smartboxchannel/WIRELESS-TEMPERATURE-HUMIDITY-SENSOR-V1-nRF52840-E73/IMAGES/BOTTOM.png

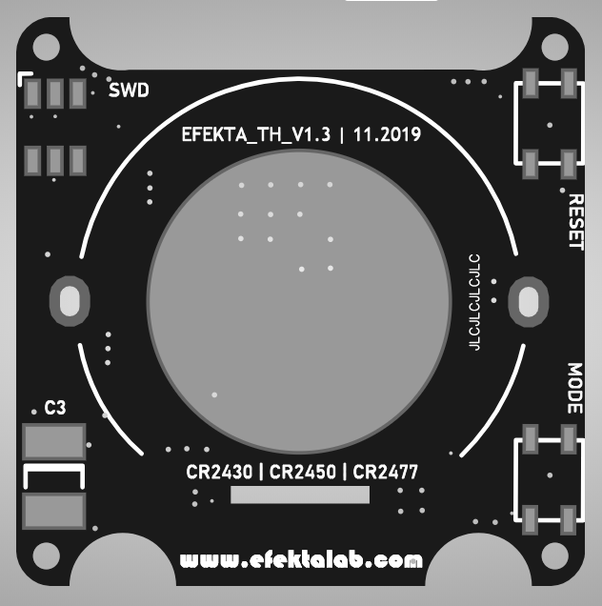
IMAGES/BOTTOM.png
