smartboxchannel/WIRELESS-TEMPERATURE-HUMIDITY-SENSOR-V1-nRF52840-E73/IMAGES/TOP.png

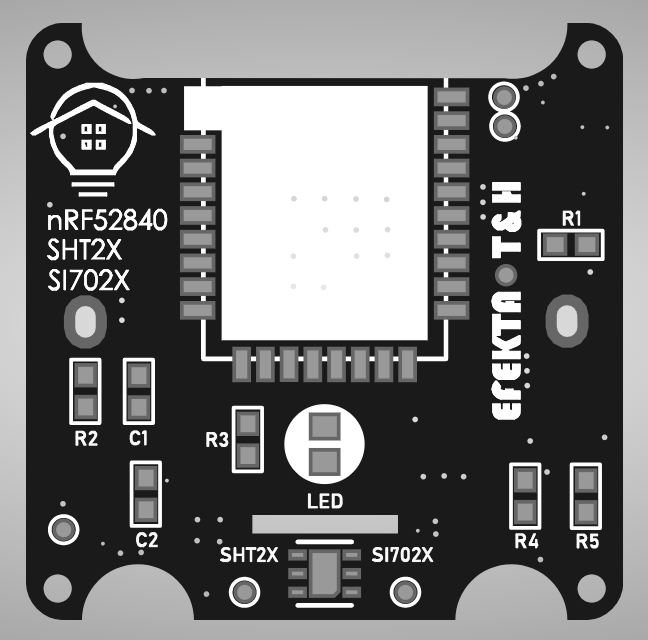
IMAGES/TOP.png
