smartboxchannel/WIRELESS-TEMPERATURE-HUMIDITY-SENSOR-V1-nRF52840-E73/SCHEMA/Schematic_EFEKTA-SHT20_2020-05-29_15-02-16.pdf

## VCC

## VCCVCC

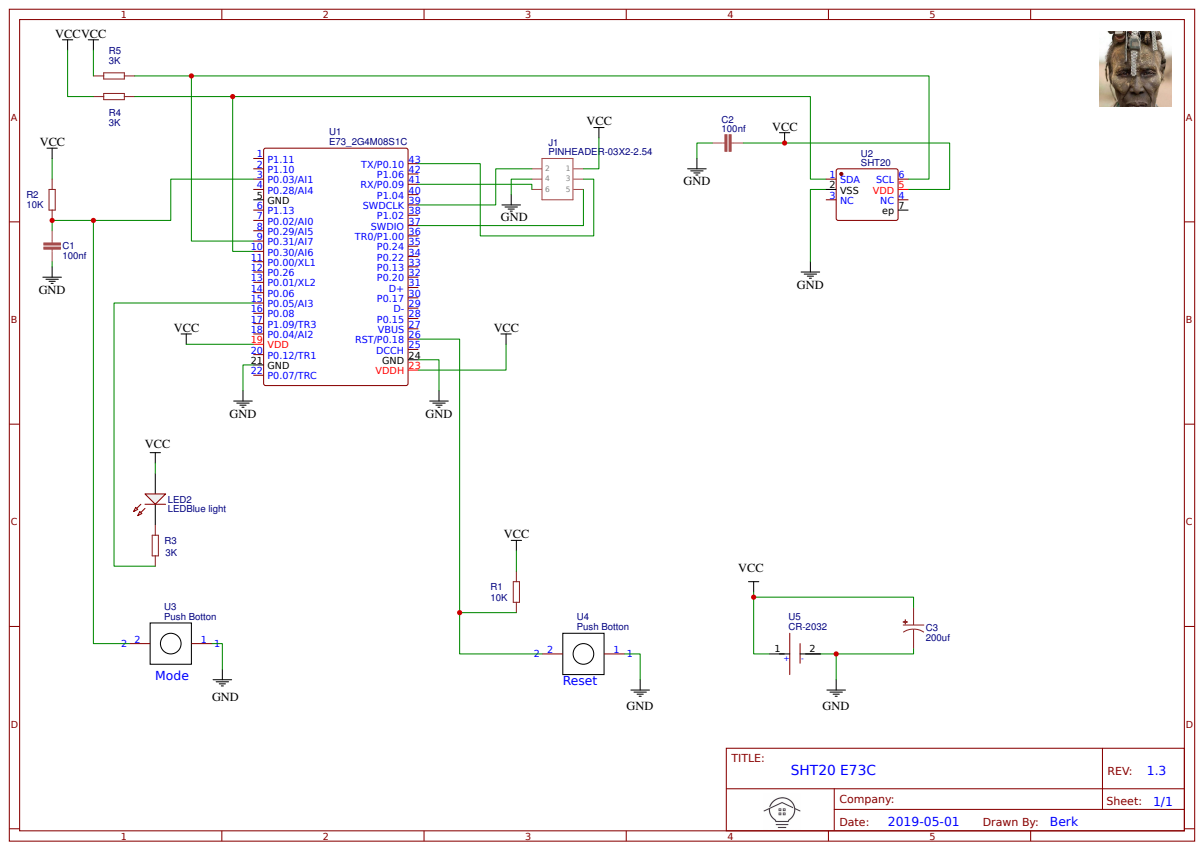
[picture p4: page 1]
